incom8134-web/3d_prints/production_cost/ai_smart_farm_dome_production_cost_2026-10-27.docx

PRODUCTION COST ESTIMATE

AI Smart Farm · 3D-printed dome · one 20-panel unit

27 October 2026 | Busan, Korea | KRW

KNOWN COST · COMPLETE PPT CHECKLIST

₩69,711 per dome

PCB board price remains open. Shipping, labor, failed prints and printer depreciation are excluded.

Printed structure

Printed panel | Qty | PLA / panel | Total PLA
Pentagon | 5 | 83.32 g | 416.60 g
Hexagon | 8 | 113.73 g | 909.84 g
Half hexagon | 6 | 62.93 g | 377.58 g
Logo / LCD hexagon | 1 | 87.18 g | 87.18 g
TOTAL | 20 | | 1,791.20 g

All 20 panels include tree supports. Estimated filament: 1.791 kg; about two nominal 1 kg spools required. Printing time: 48 h 40 min.

Requested materials and hardware

Cost item | Quantity / basis | Cost
PLA filament | 1.7912 kg × ₩24,200/kg | ₩43,347
Printer electricity | 5.11 kWh, basic tier | ₩772
White cable ties | 92 used × ₩19 | ₩1,748
Soil moisture sensor | 1 analog module | ₩530
Temperature / humidity sensor | 1 DHT11 module | ₩2,200
Light sensor | 1 CdS analog module | ₩370
DC adapter | 1 × 9 V / 1 A | ₩4,500
Crosshead machine screws | 4 × ₩80 | ₩320
Knurled thumb nuts | 8 × ₩540.50 | ₩4,324
SUBTOTAL: requested scope | PCB price excluded | ₩58,111

PCB BOARD | Qty 1 | Unit price: __________ | Extended cost: __________

Cable ties: 46 estimated joined edges × 2 ties = 92 ties. A 100-pack covers one dome.

SCOPE COMPLETION & PRICING BASIS

Additional components shown in the presentation checklist

PPT checklist item | Quantity | Indicative cost
I²C 1602 LCD | 1 | ₩2,410
5 V cooling fan | 1 | ₩3,200
5 V water pump + hose | 1 | ₩5,000
USB A–B cable | 1 | ₩990
ADDITIONAL CHECKLIST ITEMS | | ₩11,600

Cost summary

Basis | Amount | Notes
Requested scope | ₩58,111 | Printed structure + requested additions
Other PPT checklist items | ₩11,600 | LCD, fan, pump and USB cable
KNOWN COST / DOME | ₩69,711 | PCB price excluded

Calculation and procurement basis

Electricity: 48.67 h × 0.105 kW = 5.11 kWh. Basic Korean residential low-voltage tier: (₩120 + ₩9 + ₩5)/kWh, including 10% VAT and 2.7% electricity fund levy, approximately ₩772.

Consumed filament is costed at the supplied ₩24,200 per 1 kg spool. Buying two whole spools requires ₩48,400 upfront; about 209 g remains before failed prints or purge waste.

Tie geometry and hardware dimensions require assembly confirmation. The presentation labels 4 crosshead screws and 8 knurled nuts but gives no thread or length. M3 × 35 mm screws and a 20-piece thumb-nut pack are budget comparators only. Confirm thread match and adapter plug before ordering.

The presentation labels DHT11 hardware; one example code slide labels DHT22. Sensor quotation follows the physical component label. Prices below are indicative Coupang listings; recheck availability, options and delivery charges at purchase.

Price references · Coupang

Cable ties · white 140 mm, 100 pack · ₩1,900 (https://www.coupang.com/np/categories/399934)

Soil sensor · ₩530 (https://www.coupang.com/vp/products/1340116365)

DHT11 module · ₩2,200 (https://www.coupang.com/vp/products/7660919681)

Light sensor · ₩370 (https://www.coupang.com/vp/products/7662460484)

9 V adapter · ₩4,500 (https://www.coupang.com/vp/products/7937121811)

Crosshead machine screw · ₩80 each (https://www.coupang.com/vp/products/5455480043)

Knurled thumb nuts · 20 pack, ₩10,810 (https://www.coupang.com/vp/products/8253991512)

I²C LCD · ₩2,410 (https://www.coupang.com/vp/products/8410759865)

5 V fan · ₩3,200 (https://www.coupang.com/vp/products/9215656171)

5 V pump · ₩5,000 (https://www.coupang.com/vp/products/8692816437)

USB A–B cable · ₩990 (https://www.coupang.com/np/categories/497219)

Technical sources: supplied presentation, STL files and tree-support slices; KEPCO residential tariff and Q4 2026 fuel adjustment.
