incom8134-web/3d_prints/production_cost/ai_smart_farm_dome_production_cost_2026-10-27.xlsx

Sheet: 원가 견적
AI 스마트팜 돔 - 제작 원가 견적 (1대 기준)
2026년 10월 27일 | 부산 | 단위: 원(KRW) | 가격: 2026년 10월 27일 쿠팡 기준. 배송비, 인건비, 출력 실패분, 프린터 감가상각 제외.
번호 | 품목 | 사진 | 사양 / 쿠팡 상품명 | 수량 | 단위 | 단가 | 금액 | 쿠팡 링크 | 비고
A. 돔 구조물
1 | PLA 필라멘트 (출력 패널) |  | 패널 20개: 오각형 5, 육각형 8, 반육각형 6, 로고/LCD 육각형 1. 트리 서포트 사용. | 1.7912 | kg | ₩24200.0 | ₩43347.04 | https://smartstore.naver.com/jcode_edu/products/3799686722 | 1kg 스풀당 24,200원 (사용자 제공 가격). 2스풀 구매 시 48,400원, 약 209g 남음.
2 | 프린터 전기료 |  | 48시간 40분 x 0.105kW = 5.11kWh, 한전 주택용 1구간 (부가세 + 전력기금 포함) | 5.11 | kWh | ₩151.0 | ₩771.70198 |  | 부산 주택용 요금, 월 200kWh 이하 구간.
3 | 흰색 케이블타이 |  | 스마토 케이블타이 백색, 100개 | 194 | 개 | ₩11.9 | ₩2380 | https://www.coupang.com/vp/products/8850608631?itemId=25801102144 | 100개입 1,190원. 패널 변당 2개 사용, '케이블타이 계산' 시트 참고. 194개 필요, 100개입 2팩 구매 (2,380원), 금액은 팩 단위로 계산.
4 | 흑색 M3 둥근머리 볼트 (약 35-40mm) |  | 둥근머리렌치볼트 SCM 흑색 M3 (바이앤셀링쓰리) | 4 | 개 | ₩300.0 | ₩1200 | https://www.coupang.com/vp/products/9740103973 | 개당 300원 (할인가). 5mm 옵션 기준 가격 - 35-40mm 길이도 같은 가격인지 확인 필요. 배송비 3,000원 별도.
5 | M3 플랜지 너트 |  | 굿나잇몰 스텐 후렌지 플랜지 너트 M3 (피코) | 8 | 개 | ₩80.0 | ₩640 | https://www.coupang.com/vp/products/8530278620 | 개당 80원. 볼트 1개당 너트 2개. 배송비 3,500원 별도 (같은 판매자 50,000원 이상 무료배송).
 | 소계 A - 돔 구조물 |  |  |  |  |  | ₩48338.74198
B. 전자부품
1 | PCB 기판 (메인 제어 보드) |  | 맞춤 제작 스마트팜 PCB | 1 | 개 | 확인 필요 |  |  | 가격 미정 - 추후 입력.
2 | ESP32-CAM 카메라 보드 |  | 아두이노 ESP32 CAM OV2640 카메라 4M PSRAM 장착 보드 (주식회사 제이케이이엠씨) | 1 | 개 | ₩10450.0 | ₩10450 | https://www.coupang.com/vp/products/6819950767?itemId=16161419465&vendorItemId=83357050885 (https://www.coupang.com/vp/products/7608371874?itemId=20143901477) | 개당 10,450원, 2026년 10월 27일 쿠팡 확인. 배송비 3,000원 별도. 보드 단품 - CH340 업로드 보드 미포함.
3 | 토양 수분 센서 |  | 아두이노 토양 수분 센서 | 1 | 개 | ₩550.0 | ₩550 | https://www.coupang.com/vp/products/8926647066?itemId=26091903210 | 배송비 3,000원 별도.
4 | 온습도 센서 DHT11 |  | 아두이노 온습도 센서 모듈 DHT11 DM404 | 1 | 개 | ₩870.0 | ₩870 | https://www.coupang.com/vp/products/1130161191?itemId=2097870124 | 배송비 2,500원 (조건부 무료배송).
5 | 조도 센서 (CdS) |  | 아두이노 CDS 조도센서 모듈 DM460 | 1 | 개 | ₩580.0 | ₩580 | https://www.coupang.com/vp/products/166642860?itemId=477388221 | 배송비 3,000원 (조건부 무료배송).
6 | I2C 1602 LCD |  | 아두이노 텍스트 LCD 1602 IIC/I2C 모듈 A50 | 1 | 개 | ₩2000.0 | ₩2000 | https://www.coupang.com/vp/products/316031012?itemId=1004961547 | 배송비 3,000원 (조건부 무료배송).
7 | 5V 쿨링팬 40mm |  | 쿨링팬 40x40x10mm DC 5V 슬리브 | 1 | 개 | ₩1710.0 | ₩1710 | https://www.coupang.com/vp/products/9101354849?itemId=26755153028 | 배송비 3,000원 별도.
8 | 3-5V 워터펌프 (점퍼선 타입) |  | 아두이노 워터펌프 3~5V 점퍼선타입 (펀키트랩) | 1 | 개 | ₩3200.0 | ₩3200 | https://www.coupang.com/vp/products/7803032610?itemId=21138248550&vendorItemId=88199902239 (https://www.coupang.com/vp/products/8692816437?itemId=25238860630) | 개당 3,200원, 2026년 10월 27일 쿠팡 확인. 배송비 3,000원 별도. 튜브 미포함 - 필요 시 추가.
9 | DC 아답터 9V / 1A |  | (명호전자) 아답터 9V 1A 5.5x2.1~2.5mm | 1 | 개 | ₩4250.0 | ₩4250 | https://www.coupang.com/vp/products/5274840706?itemId=5630497683 | 플러그 규격이 PCB DC 잭과 맞는지 확인 필요.
10 | USB A-B 케이블 |  | USB A to B 케이블 (아두이노용) | 1 | 개 | ₩990.0 | ₩990 |  | 이전 견적 가격, 쿠팡 상품 재확인 안 함.
 | 소계 B - 전자부품 (PCB 가격 제외) |  |  |  |  |  | ₩24600
 | 합계 (A + B) 돔 1대당 |  |  |  |  |  | ₩72938.74198 |  | 아직 미포함: PCB 기판 - 가격 확정 시 추가.

Sheet: 케이블타이 계산
흰색 케이블타이 수량 - 돔 전체
패널 | 수량 | 변 개수 | 변당 케이블타이 | 케이블타이 합계 | 기준
오각형 | 5 | 5 | 2 | 50 | 변 5개 x 2개
육각형 | 8 | 6 | 2 | 96 | 변 6개 x 2개
로고 / LCD 육각형 | 1 | 6 | 2 | 12 | 변 6개 x 2개 (육각형 합계 9개)
반육각형 | 6 | 3 | 2 | 36 | 연결 변 3개 x 2개
필요 케이블타이 수량 |  |  |  | 194 | 100개입 팩 기준 필요 팩 수는 원가 견적 참고
