incom8134-web/3d_prints/cad/part-hexagon-logo-lcd-v2.step

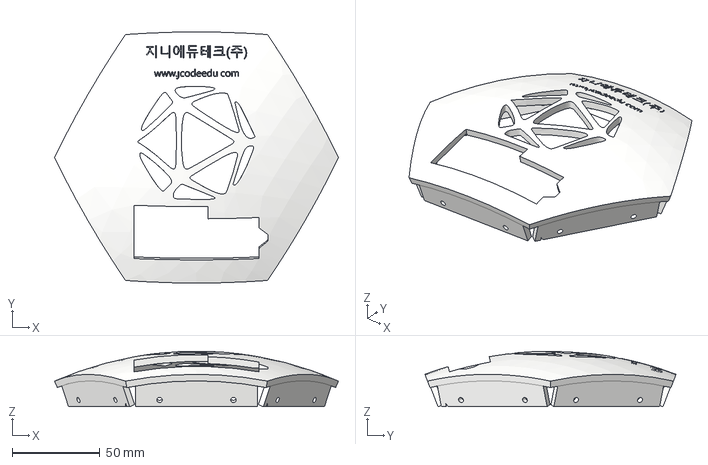
[picture p1: CAD file, 2026-11-06]
cad/part-hexagon-logo-lcd-v2.step
161.4 x 142.7 x 31.5 mm
