incom8134-web/3d_prints/models/dome_stl/part-pentagon-v2.stl

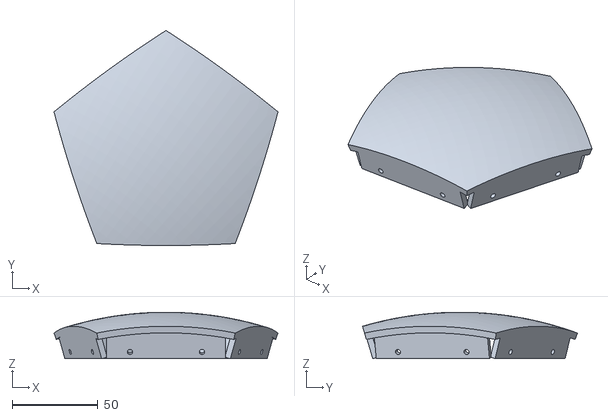
[picture p2: CAD file, 2026-11-06]
models/dome_stl/part-pentagon-v2.stl
130.6 x 125.4 x 27.1
