incom8134-web/3d_prints/models/dome_stl_v3/part-hexagon-v3.stl

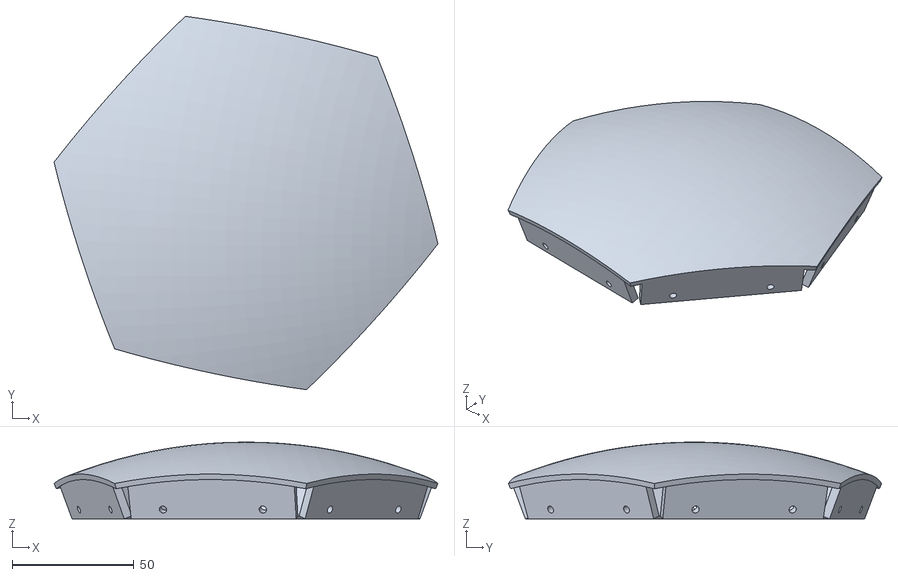
[picture p3: CAD file, 2026-11-06]
models/dome_stl_v3/part-hexagon-v3.stl
157.9 x 153.5 x 31.6
