incom8134-web/3d_prints/models/dome_stl_v3/part-half-hexagon-v3.stl

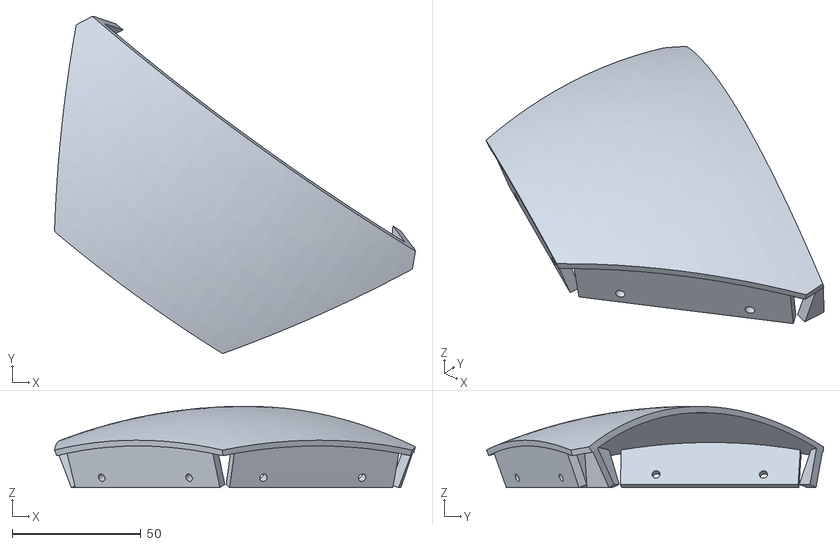
[picture p4: CAD file, 2026-11-06]
models/dome_stl_v3/part-half-hexagon-v3.stl
140.2 x 131.0 x 31.6
