incom8134-web/3d_prints/models/dome_stl/part-hexagon-logo-v2.stl

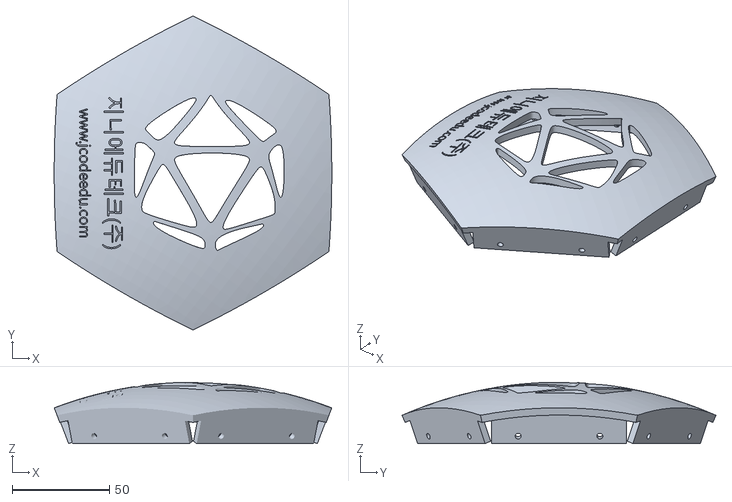
[picture p5: CAD file, 2026-11-06]
models/dome_stl/part-hexagon-logo-v2.stl
142.7 x 161.4 x 31.5
