incom8134-web/3d_prints/models/dome_stl/part-hexagon-v2.stl

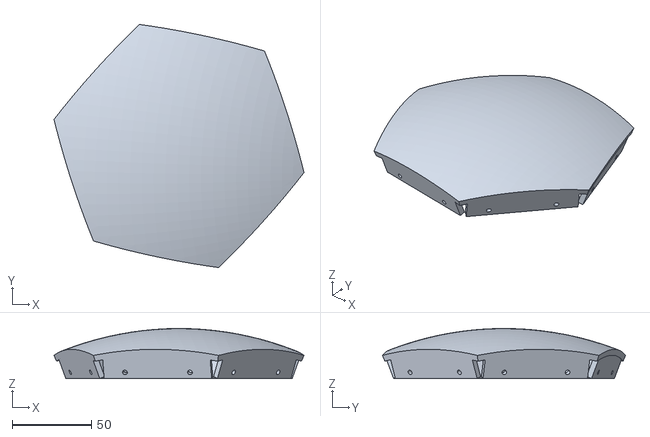
[picture p6: CAD file, 2026-11-06]
models/dome_stl/part-hexagon-v2.stl
157.9 x 153.5 x 31.6
