incom8134-web/3d_prints/(list of files, cad)

Other CAD files:
models/dome_Gcode/bambu_part-hexagon-logo-lcd-v3_PLA_4h17m.gcode.gcode.3mf
models/dome_stl_v3/part-pentagon-v3.stl
models/Gcode/transparent_oring.gcode.3mf
models/dome_Gcode/part-hexagon-logo-lcd-v3_PLA_{print_time}.gcode.3mf
models/dome_stl/part-hexagon-logo-lcd-v2.stl
models/Gcode/sliding_gate.gcode.3mf
models/dome_stl/logo_with_lcd_pentagon.gcode.3mf
models/Gcode/usb hub base plate.gcode.3mf
models/dome_stl/part-half-hexagon-v2.stl
models/dome_stl_v3/part-hexagon-logo-lcd-v3.stl
cad/dome-full-assembly.f3d
cad/part-half-hexagon-v2.f3d
cad/part-hexagon-logo-v2.f3d
cad/part-hexagon-v2.f3d
cad/part-pentagon-v2.f3d
