incom8134-web/3d_prints/(commit log)

2026-11-04 Add USB hub base plate gcode.3mf
    Hollow-bottom hub base with mounting tabs moved to the long sides.
    [usb hub base plate.gcode.3mf]
2026-11-06 Add dome gcode files
    [part-hexagon-logo-lcd-v3_PLA_{print_time}.gcode.3mf]
2026-11-06 Add hexagon logo lcd v3 PLA gcode
    [bambu_part-hexagon-logo-lcd-v3_PLA_4h17m.gcode.gcode.3mf]
2026-11-06 Add dome CAD models, print files, and cost estimates
    [ai_smart_farm_dome_production_cost_2026-10-27.xlsx, bambu_part-hexagon-logo-lcd-v3_PLA_4h17m.gcode.gcode.3mf, dome-full-assembly.f3d, logo_with_lcd_pentagon.gcode.3mf, part-half-hexagon-v2.f3d, part-half-hexagon-v2.stl, part-half-hexagon-v3.stl, part-hexagon-logo-lcd-v2.step]
